jstjst/Kart/Schaltplan.pdf

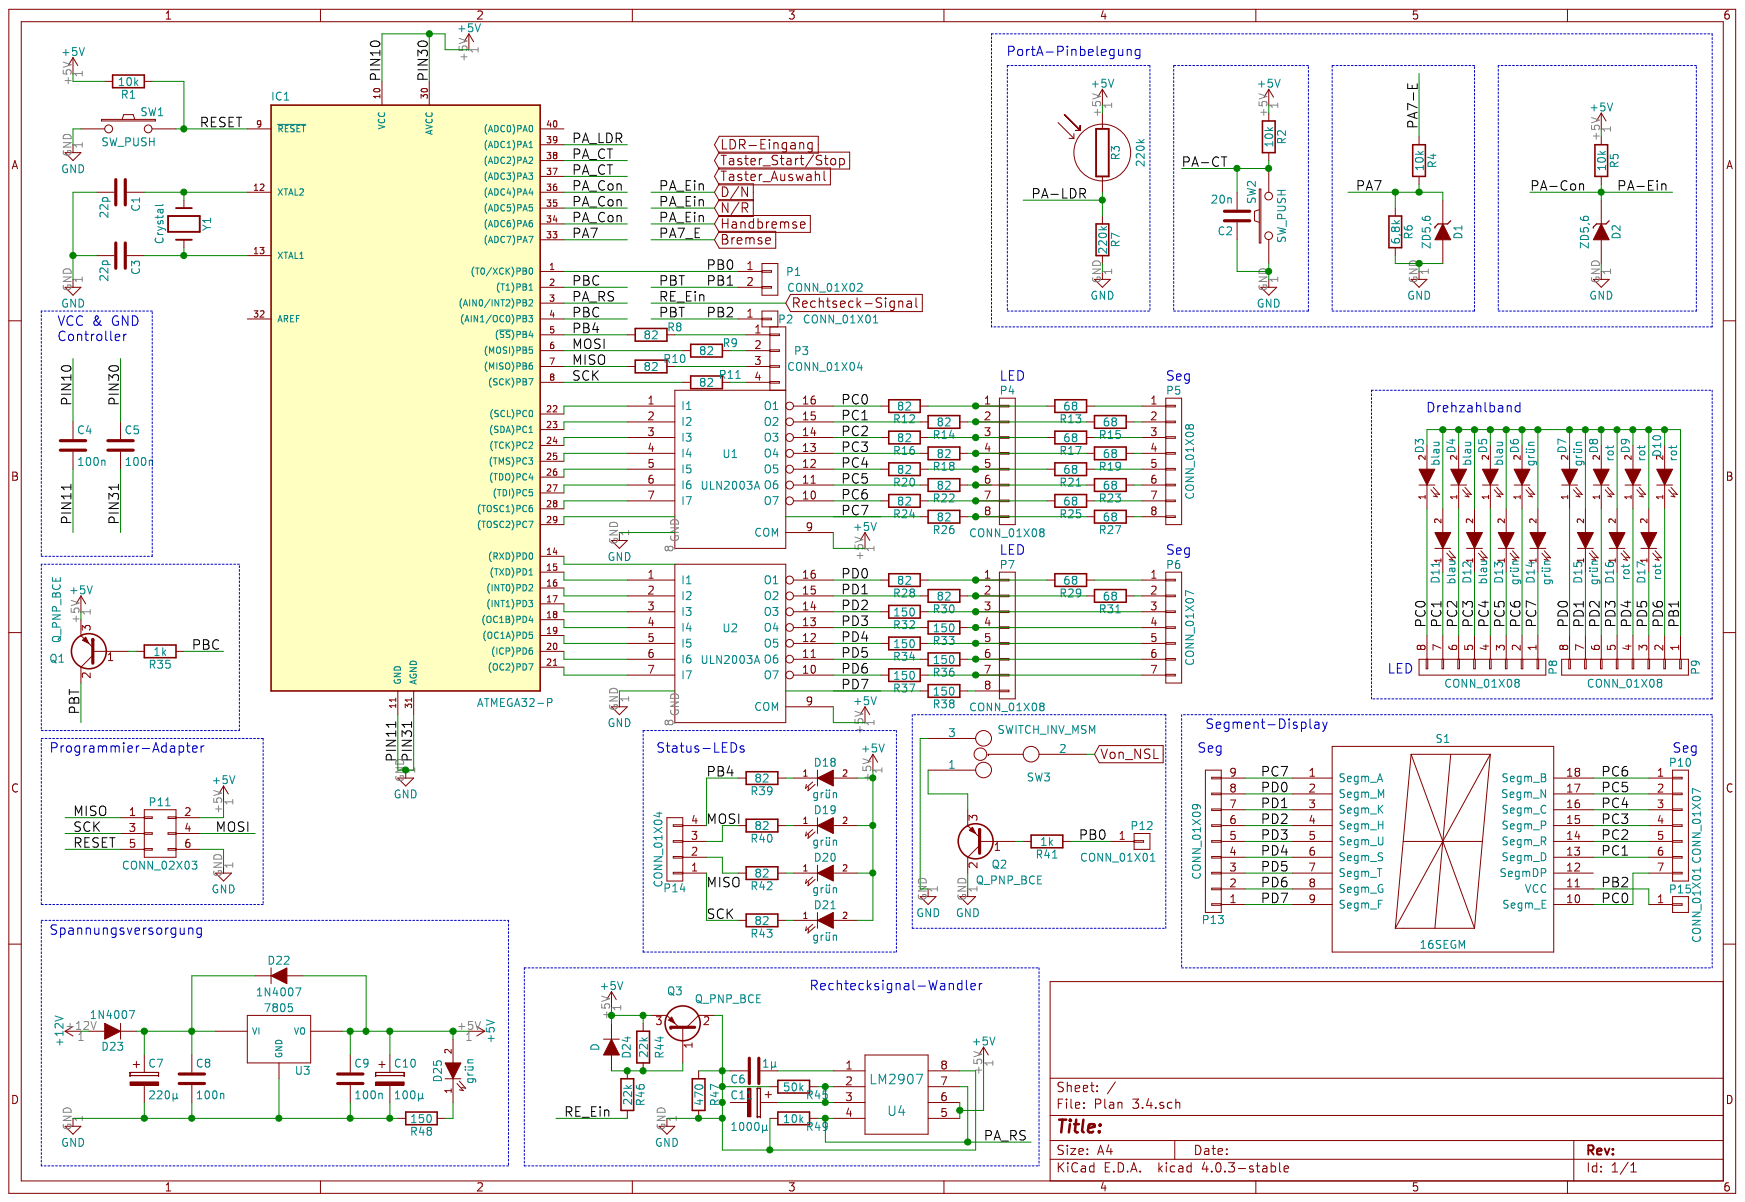
[picture p1: page 1]
