jstjst/Kart/(threads)

Thread 4 (2016-08-17):

Schaltplan: Tastenentprellung

jstjst, 2016-08-17:
Tastenentprellung fuer Start/Stop und Auswahl einfuegen.
Etwa 20nF ueber den Taster

Apokya, 2016-08-18:
Bauteil im Schaltplan eingefügt und verdrahtet

jstjst, 2016-08-19:
7bcf1eb5aa6f0bdcfc6a1fbf4e069d7088da09b8

Closed 2016-08-19.

Thread 5 (2016-08-18):

GitHub-Frage(n)

Apokya, 2016-08-18:
Ist es möglich und wenn ja, wie ist es möglich, Dateien zu löschen?
Welches Programm nutzt du für die Datei "Zustandsgrößen"?

jstjst, 2016-08-18:
git funktioniert da ein bisschen anders.
Ich hab bei mir das gesamte Repo auf dem PC. Wenn ich jetzt eine Datei aender kann ich ueber ein Kommandozeilenwerkzeug einen commit machen und dann hochladen. Gibt aber auch grafische Oberflaechen.
Schau mal hier:
https://help.github.com/
https://rogerdudler.github.io/git-guide/index.de.html

jstjst, 2016-08-18:
> Welches Programm nutzt du für die Datei "Zustandsgrößen"?
Einen Texteditor

Thread 6 (2016-08-19):

Zustand "Warnung"

Apokya, 2016-08-19:
Zustand "Warnung" wird nur im DZB durch Wechselblinken im bekannten Muster angezeigt.
Das Segment zeigt dabei aber "P" an.

Die Warnung wird auch nur ausgelöst, wenn "HB" angezogen, Gang "D" oder "R" eingelegt und Drehzahl größer Leerlauf bzw. ≥ 2000 U/min ist.

Thread 7 (2016-08-22):

Rechtecksignal-Wandler

Apokya, 2016-08-22:
Ich glaube die Kondensatoren im Schaltbild unter "Recktecksignal-Wandler" sind von mir falsch beschriftet worden.
Könntest du dort bitte einmal drüber schauen?
Sind auch die Leiterbahnen korrekt?

Apokya, 2016-08-22:
Und: Wie mit welchen Steckern und Kablen würdest du Leiterbahnen verbinden, die nicht übereinander liegen?
Müsste bei Reichelt erhaltbar sein.

jstjst, 2016-08-22:
Da sind einige Fehler
Schau es dir noch mal selber an:
http://www.fda-technology.de/images/1.6.zip

jstjst, 2016-08-22:
> Und: Wie mit welchen Steckern und Kablen würdest du Leiterbahnen verbinden, die nicht übereinander liegen?
Müsste bei Reichelt erhaltbar sein.

Wie meinst du das

Apokya, 2016-08-22:
Ich trenne ja die Platine für das Segment und das DZB auf auf eigene Platten. Ich frage mich nur, wie ich die platzsparend kabel-/ signaltechnisch verbinden kann.

jstjst, 2016-08-22:
Flachbandkabel mit Stift- und Buchsenleisten
Musst du halt selbst zusammenlöten

Apokya, 2016-08-23:
Hardware bestellt. Ich hoffe nach dem Zusammenbau haben wir ein sauberes Signal.
Ich halte dich auf dem Laufenden.

Thread 8 (2016-08-23):

Status Hard- und Software

Apokya, 2016-08-23:
Ich trage hier alle Veränderungen an der und um die Hardware ein, damit du weißt, wie weit ich bin.
Dich würde ich bitten bezüglich Software immer mal wieder hier rein zu schreiben wie weit du bist.
Dabei vorrangig, ob ich das Programm schon testweise aufspielen kann o. ä.

Hardware wurde heute bestellt und ist morgen da.
Die Tage werde ich mich dann an den Aufbau begeben und hoffe bis zum Wochenende programmierfertig zu werden.

jstjst, 2016-08-23:
Also die Software ist eigentlich so weit fertig, dass ein testen der LEDs möglich ist.
Ich mach hier in den nächsten Tagen ein release, dass du dann testen kannst

Apokya, 2016-08-24:
Eine Frage zur Hardware: Wie herum muss der 6-Pin-ISP-Wannenstecker eingebaut werden? Wo ist dort welcher Pin? Oder egal?

jstjst, 2016-08-24:
kannst du googeln

Apokya, 2016-09-01:
Hardware ist seit dem 30.08.2016 fertiggestellt und geprüft.
Alles funktioniert problemlos. Es fehlt nur noch die Prüfung vom Rechtecksignal-Wandler (RW).

Zur Software: Es war mir bis heute, dem 01.09.2016, unmöglich deinen Code über Arduino direkt auf den ATmega zu brennen. Daher konnte ich einen Softwaretest nicht ausführen.
Allerdings habe ich dazu ein altes von mir geschriebenes Programm ausgepackt, angepasst und geladen und damit alle LEDs und Transistoren getestet (Außer PWM, RW).

Entweder gibt es eine Möglichkeit die ArduinoIDE ohne Board zu nutzen, die ich nicht kenne und auch mit Hilfe von Google nicht herausfinden konnte, oder du müsstest den Code vor dem Release bei dir in Hex umwandeln. Ich nutze zur Zeit Bascom und lade, da das mit den Fuses nicht so funktioniert in Bascom, mit myAVR_ProgTool auf den Chip.
In Arduino ist es mir bis jetzt unmöglich den ATmega32 zu beschreiben. Er erkennt nicht einen Pin (z.B. PA1 - PA7 oder OXR0, u.s.w.)

jstjst, 2016-09-02:
Du musst erst den ATmega32 hinzufügen:
https://learn.adafruit.com/add-boards-arduino-v164/setup
https://mcudude.github.io/MightyCore/package_MCUdude_MightyCore_index.json
Dann unter tools -> board den mega32 auswählen und Frequenz einstellen.

Dann kannst du unter Sketch -> Export Compiled Binary die hex Datei exportieren

Apokya, 2016-09-02:
Vielen Dank, hat super geklappt.

Aber leider ist das Programm fehlerhaft.

Durch rumprobieren habe ich herausgefunden, dass zu mindest bis nach der Warnung die Transistoransteuerung falsch herum ist, obwohl die Pin korrekt deklariert wurden.
Dadurch werden die Zeichen & Zahlen auf dem DZB angezeigt.

Wenn ich zum Test am Codeanfang PB1 mit PB3 vertausche läuft erstmal alles gut.
Allerdings funktioniert das "leeren" nicht. Denn dann beginnt es in der Mitte , leert ein Teil der roten und die blauen LEDs und beendet dann mit grün und dem Rest rot.
Die Zeichen, nicht Zahlen, sind unvollständig. Bei allen wird die linke Hälfte nicht angezeigt, also PortD.

Sollte ich aber alles so lassen, geht das DZB statt dem SEG an und umgekehrt.

Und eine Frage: Sind die Eingänge "DN", "NR", "HB" und "B" schon implementiert? Denn wenn ich dort Masse auflege, passiert nichts.

Am Ende leuchten alle 4 StatusLEDs auf.

Ansonsten schon super Arbeit. Bin gespannt, wie das aussieht, wenn PWM funktioniert und beim Start das DZB und SEG gleichzeitig laufen :)

Apokya, 2016-09-04:
Soo, ich habe in den Ordner "LED-Test" eine neue Version "Kart-v0.9.1" hochgeladen.
Tut mir Leid, wenn ich an der falschen Stelle hochgeladen habe ;)

Dort sind, soweit ich mit dem Programm-Code umgehen konnte, fast alle Fehler "gefixt".
PB1 und PB3 bleiben getauscht.
Zu Beginn leuchtet 4 Sekunden lang nichts, ich gehe da von einem Fehler bei den StatusLEDs aus.
Kann den Fehler aber nicht finden.
Danach läuft das DZB und das Seg wie gewünscht, ohne Fehler.

Apokya, 2016-10-12:
Huhu. Gibt es schon neue Software-Entwicklungen?
Irgendwas, was ich testen kann?
Gibt es Probleme bzw. kann ich helfen?

Thread 9 (2016-08-24):

Weiterer PWM-Anschluss?

Apokya, 2016-08-24:
Ich habe eine Frage:

Und zwar ist geplant, dass ich die Kontrolleuchten für Blinker, Fernlicht, Tagfahrlicht, u.s.w. direkt an 12 V mit Vorwiderstand anschließe. Jetzt fiel mir aber ein, dass das evtl. nicht so ne gute Idee ist, wegen der Leuchtkraft der LEDs.

Ist es möglich, dass an einem Kontakt der LED einmal
- die PWM-Leuchtregulierung und einmal
- 12V bzw. Masse des Karts anliegt und
dadruch auch diese LEDs in der Leuchtintensität geändert werden können, so wie auch die LEDs des DZB und der Seg.?

Welche Möglichkeiten gibt es? Wenn 12V-15V anliegen, welcher Vorwiderstand wäre es?
Was würde fehlen, wenn es umsetzbar wäre?

Apokya, 2016-08-25:
Gedacht war den Anschluss PA1 zu nutzen.
Evtl. würde aber auch ein anderer Pin gehen.

Ich würde über den Pin dann Transistoren als digitale Schalter ansteuern (über Basis).
Der Emmitter liegt auf bzw. an Fahrzeug-Masse.
Über die Versorgung von 12V-15V bekommen die LEDs dann Spannung, die über einen Vorwiederstand auf das nötige Maß reduziert wird, bevor sie in den Kollektor des Transistors fließt.

Wäre das machbar? Ich muss nähmlich noch Teile nachbestellen, auch, weil etwas falsch geliefert wurde und vorausgesetzt ich muss den Versand nicht nochmal bezahlen, würde ich das morgen gerne machen.

Wenn du mir das sagen könntest, ob das so geht, bzw. ne gute Idee wäre, oder ein anderer Aufbau besser wäre und dazu die nötigen Bauteile, wäre das super.
Ansonsten bleibt das erstmal außen vor.

Apokya, 2016-08-26:
Sry für den Stress vor dem Urlaub. Es kommt sowieso Versandt drauf, also besprechen wir das, wenn du wieder zurück bist ;)

Apokya, 2016-09-21:
Hi mein Bester,

es wäre total super von dir, wenn wir uns die Tage noch einmal zu einem Gespräch treffen könnten.
Bitte gebe mir Bescheid, wann es dir am Besten passt.

Gruß Apokya

jstjst, 2016-10-03:
Ja das geht so wie du es dir vorstellst.
Bezüglich der Vorwiederstände sind diese eigentlich nicht notwendig, höchstens zur Anpassung von verschiedenen LED Farben.

Apokya, 2016-10-03:
Brauche ich für jede LED einen eigenen Transistor oder würde ein einziger reichen?
Es werden grüne LEDs und eine blaue LED benutzt.

jstjst, 2016-10-03:
Es reicht einer

Apokya, 2016-10-03:
Und wie sieht es mit den Vorwiderständen aus?
Es muss bestimmt jede LED einen haben.
Hast du noch Zeit und Lust mit die für 12 oder 15V für alle Farben zu berechnen?
Und wie groß sollte der Transistor sein? Einer von den gekauften reicht oder muss mit mehr mA gerechnet werden?

Und auch wenns hier nicht hingehört: Ist es möglich schon Drehzahl zu messen, um zu prüfen, ob die Hardware in dem Bereich einwandfrei funktioniert?
