jstjst/Kart/(commit log)

2016-08-15 Grundstruktur und LED Multiplexing
2016-08-16 Zwei Bytes fuer LED-Multiplexing in ein Word zusammengefasst
2016-08-17 Bitweise Operation statt Konstante (issue #3)
    [Kart.ino]
2016-08-17 Startbild optimiert und Zeiten einstellbar gemacht
2016-08-18 Zustandstabelle Gaende und Pseudocode
2016-08-18 Funktion Gang von Pseudocode geschrieben Eingaenge Gaenge und Bremsen
